btb/a2pico/A2Pico.v2.7/A2Pico.v2.7.sch.pdf

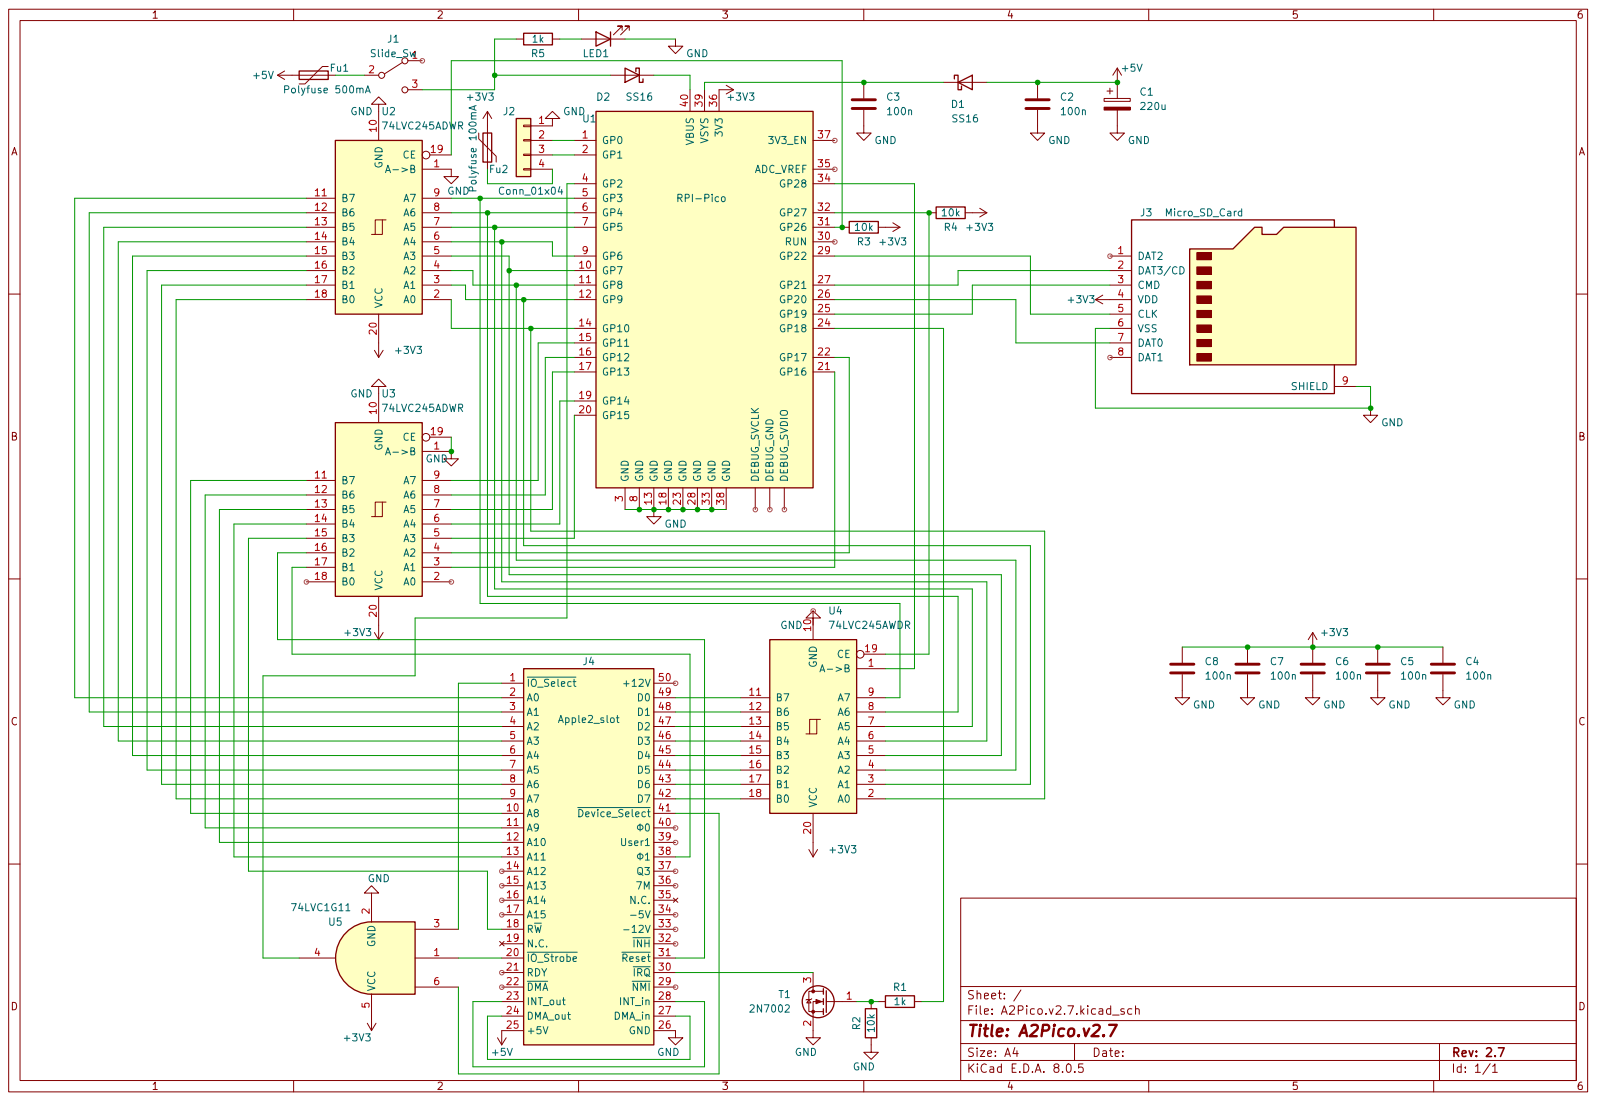
[picture p2: page 1]
