btb/a2pico/A2Pico.v2.6/A2Pico.v2.6.sch.pdf

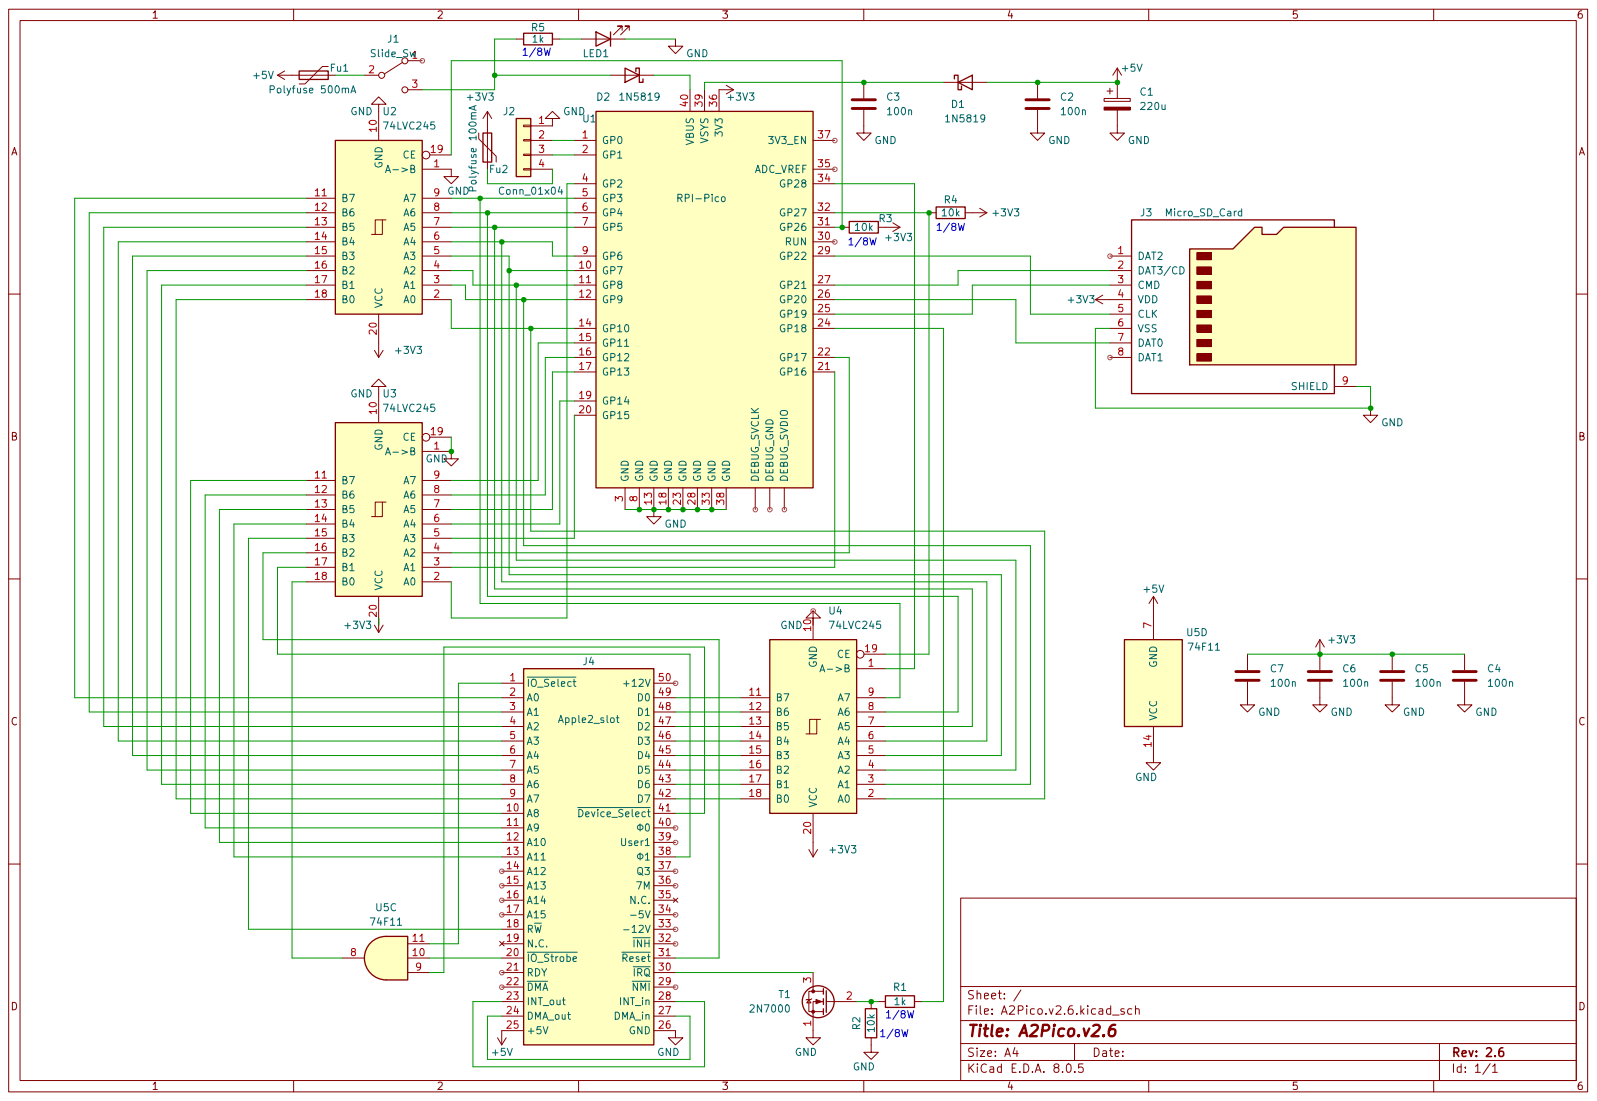
[picture p3: page 1]
