btb/a2pico/A2Pico.v2.7.BookII/A2Pico.v2.7.BookII.kicad_pcb

## KiCad design A2Pico.v2.7.BookII/A2Pico.v2.7.BookII.kicad_pcb (2026-09-29)

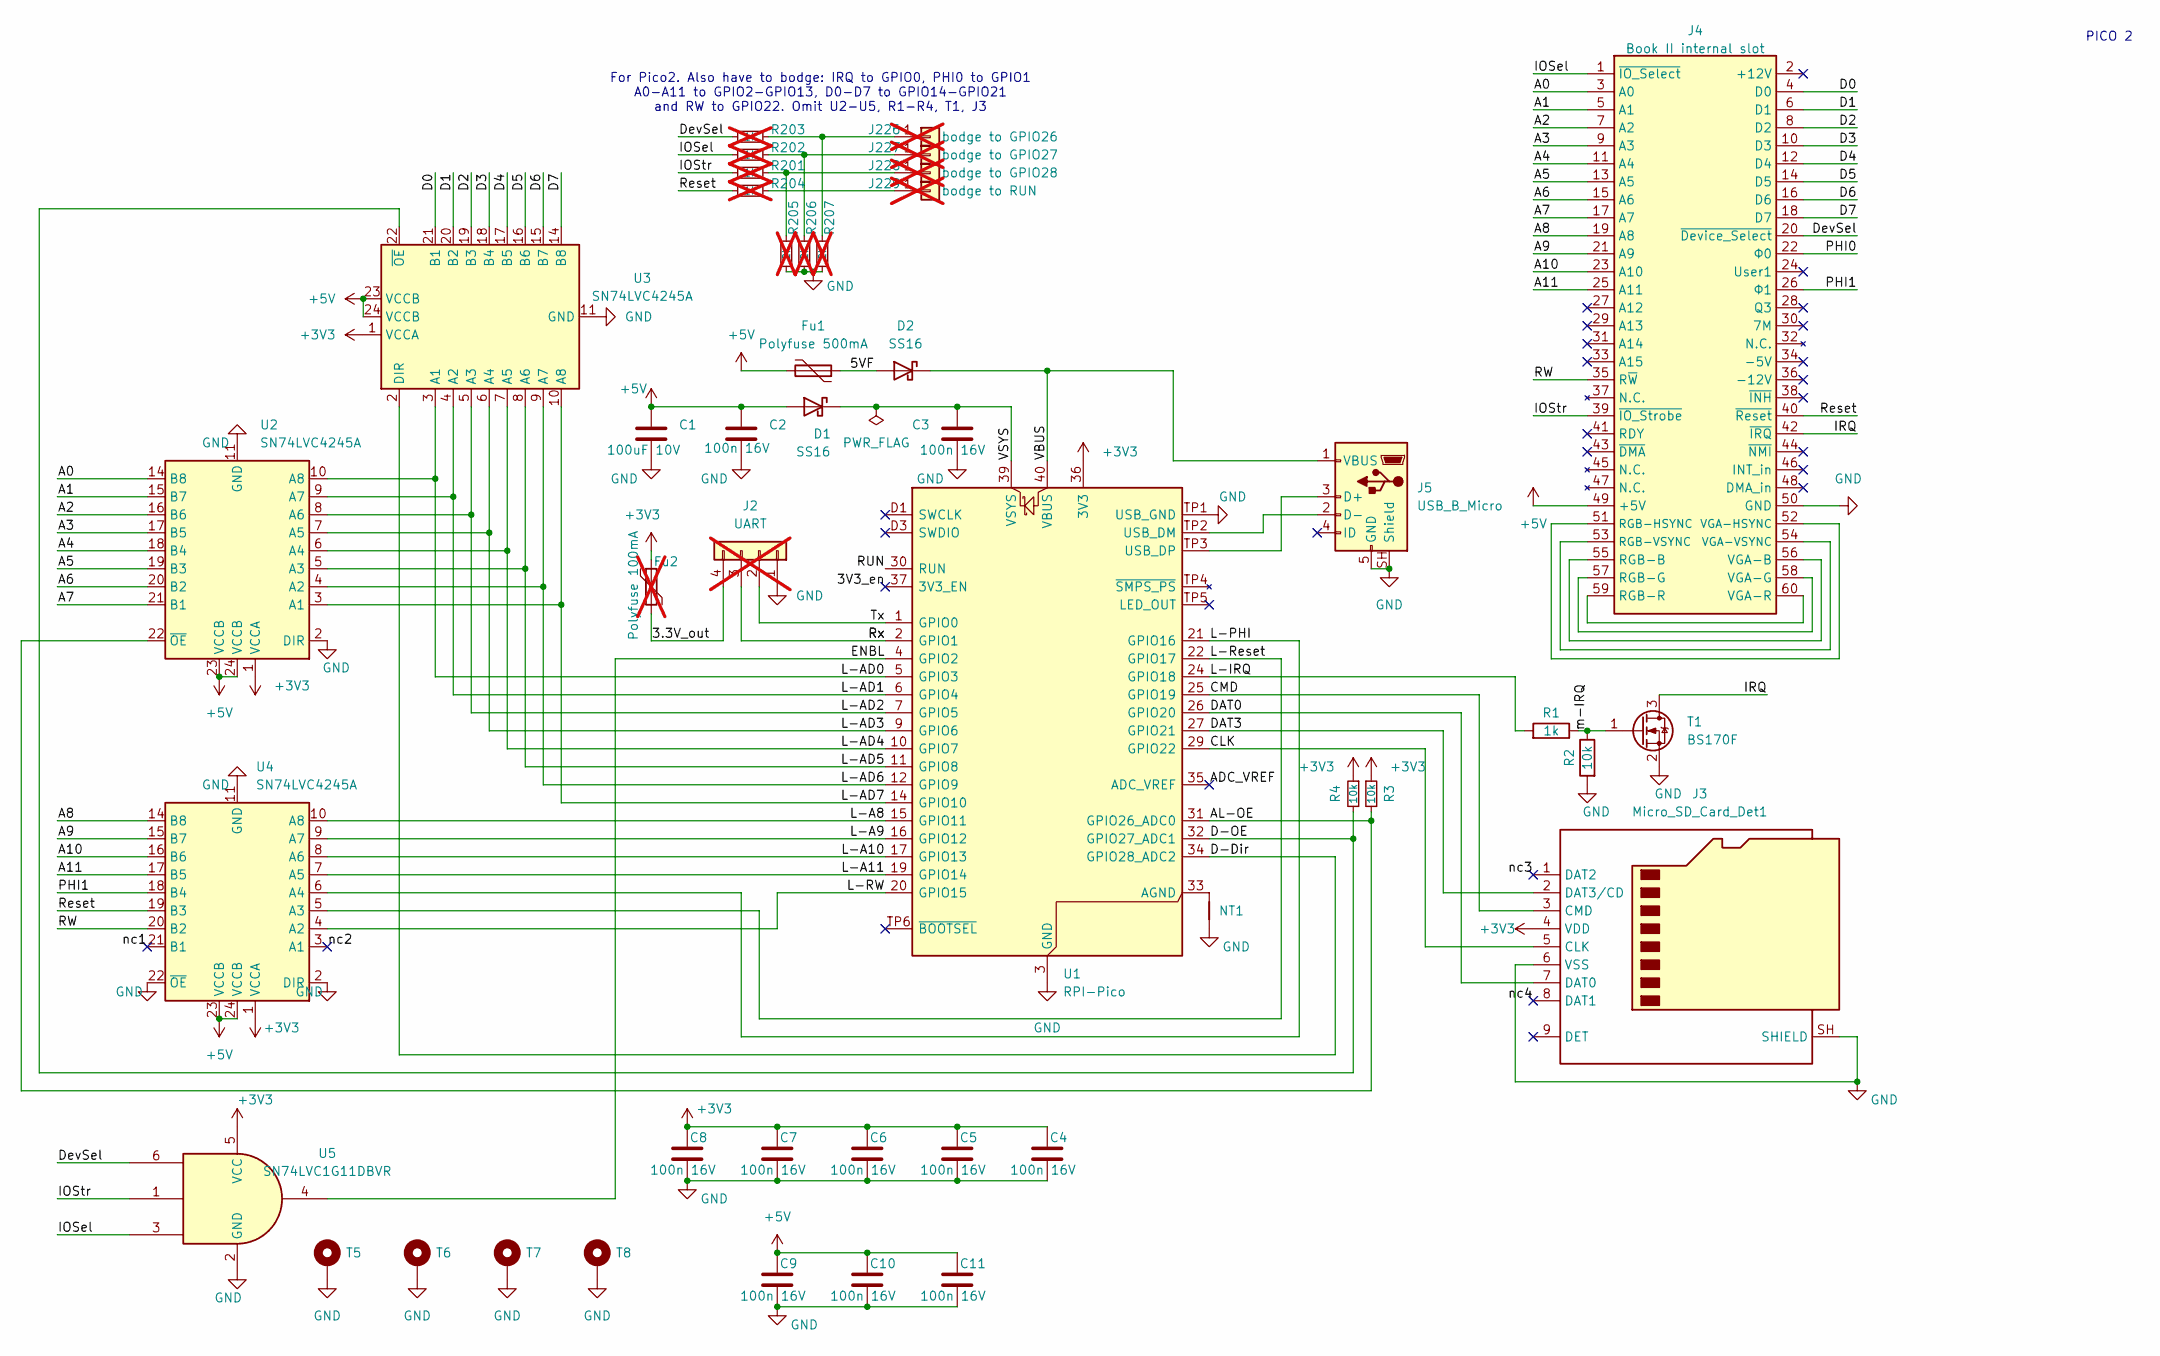
[picture p4: schematic A2Pico.v2.7.BookII.kicad_sch, A2Pico.v2.7 for Book II]

Parts:
C1: 100uF 10V; C_1206_3216Metric_Pad1.33x1.80mm_HandSolder; JLCPCB Part # C15008
C2, C3, C4, C5, C6, C7, C8, C9, C10, C11: 100n 16V; C_0603_1608Metric_Pad1.08x0.95mm_HandSolder; JLCPCB Part # C14663
D1, D2: SS16; D_SMA_Handsoldering; JLCPCB Part # C2480
Fu1: Polyfuse 500mA; Fuse_0805_2012Metric_Pad1.15x1.40mm_HandSolder; JLCPCB Part # C269102
Fu2: Polyfuse 100mA; Fuse_0805_2012Metric_Pad1.15x1.40mm_HandSolder; JLCPCB Part # C269101; not fitted
J2: UART; PinHeader_1x04_P2.54mm_Horizontal; not fitted
J3: Micro_SD_Card_Det1; MicroSD_CUI_MSD-4-A; JLCPCB Part # C52750848
J4: Book II internal slot; PinSocket_2x30_P2.54mm_Vertical
J5: USB_B_Micro; USB_Micro-B_Amphenol_10118193-0001LF_Horizontal; JLCPCB Part # C6798311
J226: bodge to GPIO26; PinHeader_1x01_P1.00mm_Vertical; not fitted
J227: bodge to GPIO27; PinHeader_1x01_P1.00mm_Vertical; not fitted
J228: bodge to GPIO28; PinHeader_1x01_P1.00mm_Vertical; not fitted
J229: bodge to RUN; PinHeader_1x01_P1.00mm_Vertical; not fitted
NT1: (no value)
R1: 1k; R_0603_1608Metric_Pad0.98x0.95mm_HandSolder; JLCPCB Part # C21190
R2, R3, R4: 10k; R_0603_1608Metric_Pad0.98x0.95mm_HandSolder; JLCPCB Part # C25804
R201, R202, R203, R204: 1k; R_0603_1608Metric_Pad0.98x0.95mm_HandSolder; not fitted
R205, R206, R207: 2k; R_0603_1608Metric_Pad0.98x0.95mm_HandSolder; not fitted
T1: BS170F; SOT-23_Handsoldering; JLCPCB Part # C8545
T5, T6, T7, T8: MountingHole_Pad; M2.8D4.5
U1: RPI-Pico
U2, U3, U4: SN74LVC4245A; TSSOP-24_4.4x7.8mm_P0.65mm; JLCPCB Part # C7859
U5: SN74LVC1G11DBVR; SOT-23-6_Handsoldering; JLCPCB Part # C22046

Connections:
+3V3: C4.1, C5.1, C6.1, C7.1, C8.2, Fu2.1, J3.4 (VDD), R3.1, R4.1, U1.36 (3V3), U2.1 (VCCA), U3.1 (VCCA), U4.1 (VCCA), U5.5 (VCC)
+5V: C1.1, C2.1, C9.2, C10.1, C11.1, D1.2 (A), Fu1.2, J4.49 (+5V), U2.23 (VCCB), U2.24 (VCCB), U3.23 (VCCB), U3.24 (VCCB), U4.23 (VCCB), U4.24 (VCCB)
/3.3V_out: Fu2.2, J2.4
/3V3_en: U1.37 (3V3_EN)
/5VF: D2.2 (A), Fu1.1
/A0: J4.3 (A0), U2.14 (B8)
/A1: J4.5 (A1), U2.15 (B7)
/A2: J4.7 (A2), U2.16 (B6)
/A3: J4.9 (A3), U2.17 (B5)
/A4: J4.11 (A4), U2.18 (B4)
/A5: J4.13 (A5), U2.19 (B3)
/A6: J4.15 (A6), U2.20 (B2)
/A7: J4.17 (A7), U2.21 (B1)
/A8: J4.19 (A8), U4.14 (B8)
/A9: J4.21 (A9), U4.15 (B7)
/A10: J4.23 (A10), U4.16 (B6)
/A11: J4.25 (A11), U4.17 (B5)
/ADC_VREF: U1.35 (ADC_VREF)
/AL-OE: R3.2, U1.31 (GPIO26_ADC0), U2.22 (~OE)
/CLK: J3.5 (CLK), U1.29 (GPIO22)
/CMD: J3.3 (CMD), U1.25 (GPIO19)
/D0: J4.4 (D0), U3.21 (B1)
/D1: J4.6 (D1), U3.20 (B2)
/D2: J4.8 (D2), U3.19 (B3)
/D3: J4.10 (D3), U3.18 (B4)
/D4: J4.12 (D4), U3.17 (B5)
/D5: J4.14 (D5), U3.16 (B6)
/D6: J4.16 (D6), U3.15 (B7)
/D7: J4.18 (D7), U3.14 (B8)
/D-Dir: U1.34 (GPIO28_ADC2), U3.2 (DIR)
/D-OE: R4.2, U1.32 (GPIO27_ADC1), U3.22 (~OE)
/DAT0: J3.7 (DAT0), U1.26 (GPIO20)
/DAT3: J3.2 (DAT3/CD), U1.27 (GPIO21)
/DevSel: J4.20 (~Device_Select), R203.1, U5.6
/ENBL: U1.4 (GPIO2), U5.4
/IOSel: J4.1 (~IO_Select), R202.1, U5.3
/IOStr: J4.39 (~IO_Strobe), R201.1, U5.1
/IRQ: J4.42 (~IRQ), T1.3 (D)
/L-A8: U1.15 (GPIO11), U4.10 (A8)
/L-A9: U1.16 (GPIO12), U4.9 (A7)
/L-A10: U1.17 (GPIO13), U4.8 (A6)
/L-A11: U1.19 (GPIO14), U4.7 (A5)
/L-AD0: U1.5 (GPIO3), U2.10 (A8), U3.3 (A1)
/L-AD1: U1.6 (GPIO4), U2.9 (A7), U3.4 (A2)
/L-AD2: U1.7 (GPIO5), U2.8 (A6), U3.5 (A3)
/L-AD3: U1.9 (GPIO6), U2.7 (A5), U3.6 (A4)
/L-AD4: U1.10 (GPIO7), U2.6 (A4), U3.7 (A5)
/L-AD5: U1.11 (GPIO8), U2.5 (A3), U3.8 (A6)
/L-AD6: U1.12 (GPIO9), U2.4 (A2), U3.9 (A7)
/L-AD7: U1.14 (GPIO10), U2.3 (A1), U3.10 (A8)
/L-IRQ: R1.2, U1.24 (GPIO18)
/L-PHI: U1.21 (GPIO16), U4.6 (A4)
/L-RW: U1.20 (GPIO15), U4.4 (A2)
/L-Reset: U1.22 (GPIO17), U4.5 (A3)
/PHI0: J4.22 (Ф0)
/PHI1: J4.26 (Ф1), U4.18 (B4)
/RUN: U1.30 (RUN)
/RW: J4.35 (R~W), U4.20 (B2)
/Reset: J4.40 (~Reset), R204.1, U4.19 (B3)
/Rx: J2.3, U1.2 (GPIO1)
/Tx: J2.2, U1.1 (GPIO0)
/VBUS: D2.1 (K), J5.1 (VBUS), U1.40 (VBUS)
/VSYS: C3.1, D1.1 (K), U1.39 (VSYS)
/m-IRQ: R1.1, R2.1, T1.1 (G)
/nc1: U4.21 (B1)
/nc2: U4.3 (A1)
/nc3: J3.1 (DAT2)
/nc4: J3.8 (DAT1)
GND: C1.2, C2.2, C3.2, C4.2, C5.2, C6.2, C7.2, C8.1, C9.1, C10.2, C11.2, J2.1, J3.6 (VSS), J3.SH (SHIELD), J4.50 (GND), J5.5 (GND), J5.SH (Shield), NT1.2, R2.2, R205.1, R206.1, R207.1, T1.2 (S), T5.1 (1_1), T6.1 (1_1), T7.1 (1_1), T8.1 (1_1), U1.3 (GND), U1.8 (GND), U1.13 (GND), U1.18 (GND), U1.23 (GND), U1.28 (GND), U1.38 (GND), U1.D2 (GND), U1.TP1 (USB_GND), U2.2 (DIR), U2.11 (GND), U2.12 (GND), U2.13 (GND), U3.11 (GND), U3.12 (GND), U3.13 (GND), U4.2 (DIR), U4.11 (GND), U4.12 (GND), U4.13 (GND), U4.22 (~OE), U5.2 (GND)
unnamed: J4.55 (RGB-B), J4.56 (VGA-B)
unnamed: J4.57 (RGB-G), J4.58 (VGA-G)
unnamed: J4.51 (RGB-HSYNC), J4.52 (VGA-HSYNC)
unnamed: J4.59 (RGB-R), J4.60 (VGA-R)
unnamed: J4.53 (RGB-VSYNC), J4.54 (VGA-VSYNC)
unnamed: J5.3 (D+), U1.TP3 (USB_DP)
unnamed: J5.2 (D-), U1.TP2 (USB_DM)
unnamed: J226.1 (Pin_1_1), R203.2, R207.2
unnamed: J227.1 (Pin_1_1), R202.2, R206.2
unnamed: J228.1 (Pin_1_1), R201.2, R205.2
unnamed: J229.1 (Pin_1_1), R204.2
unnamed: NT1.1, U1.33 (AGND)

Notes on the sheet:
PICO 2
For Pico2. Also have to bodge: IRQ to GPIO0, PHI0 to GPIO1 A0-A11 to GPIO2-GPIO13, D0-D7 to GPIO14-GPIO21 and RW to GPIO22. Omit U2-U5, R1-R4, T1, J3

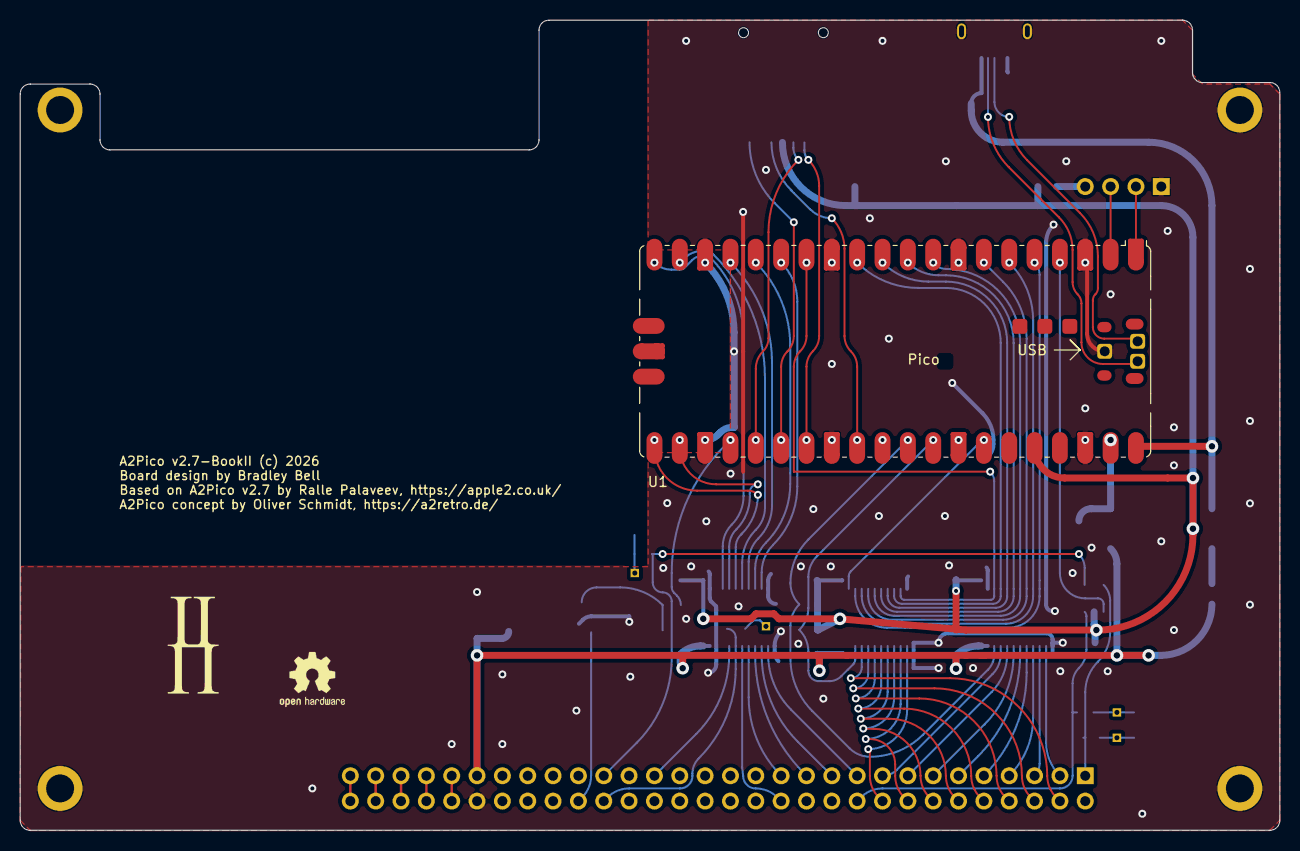
[picture p5: board A2Pico.v2.7.BookII.kicad_pcb from above]

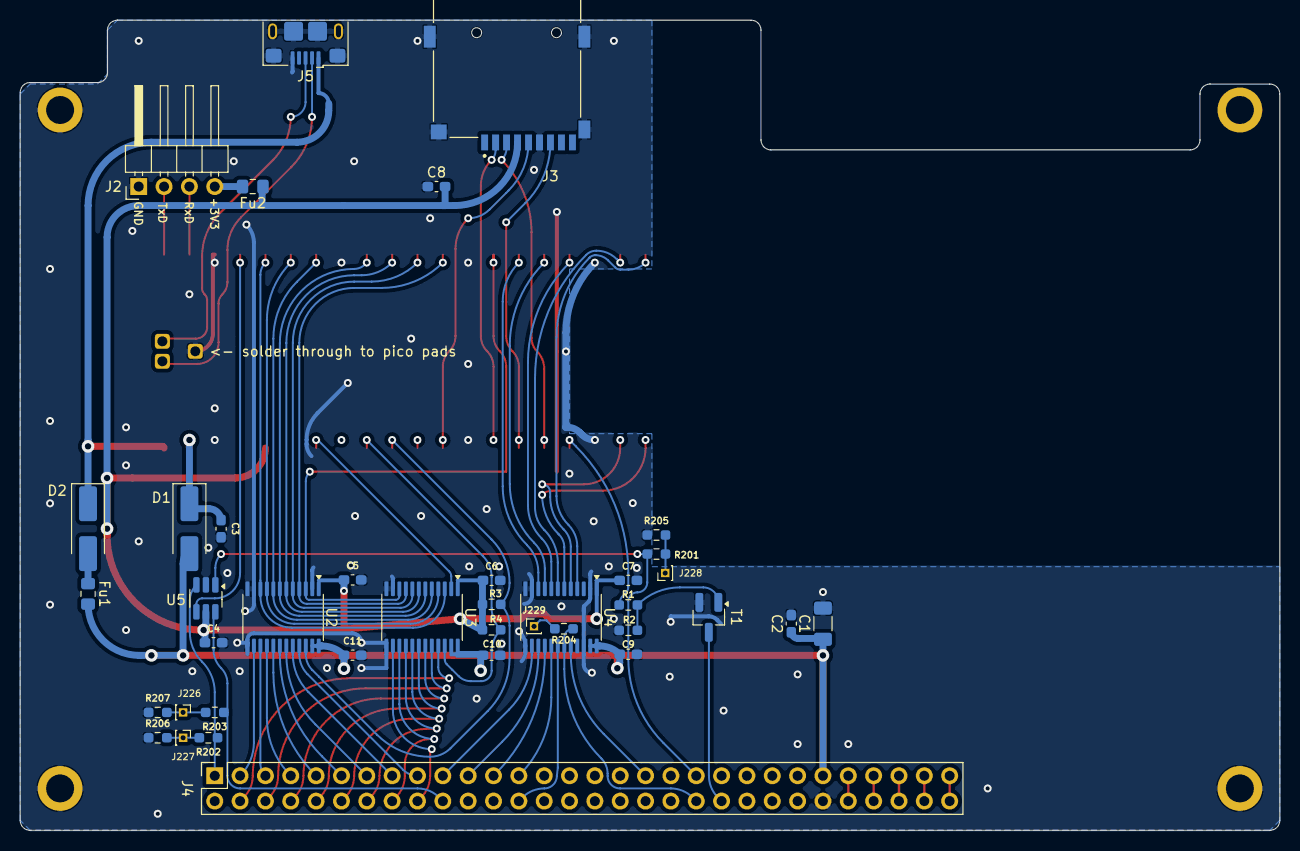
[picture p6: board A2Pico.v2.7.BookII.kicad_pcb from below]

Board: 2 copper layers, 126.2 x 81.2 mm, 44 parts (39 on the bottom side), 72 nets.
