btb/a2pico/A2Pico.v2.6/A2Pico.v2.6.kicad_pcb

## KiCad design A2Pico.v2.6/A2Pico.v2.6.kicad_pcb (2026-02-10, an earlier design)

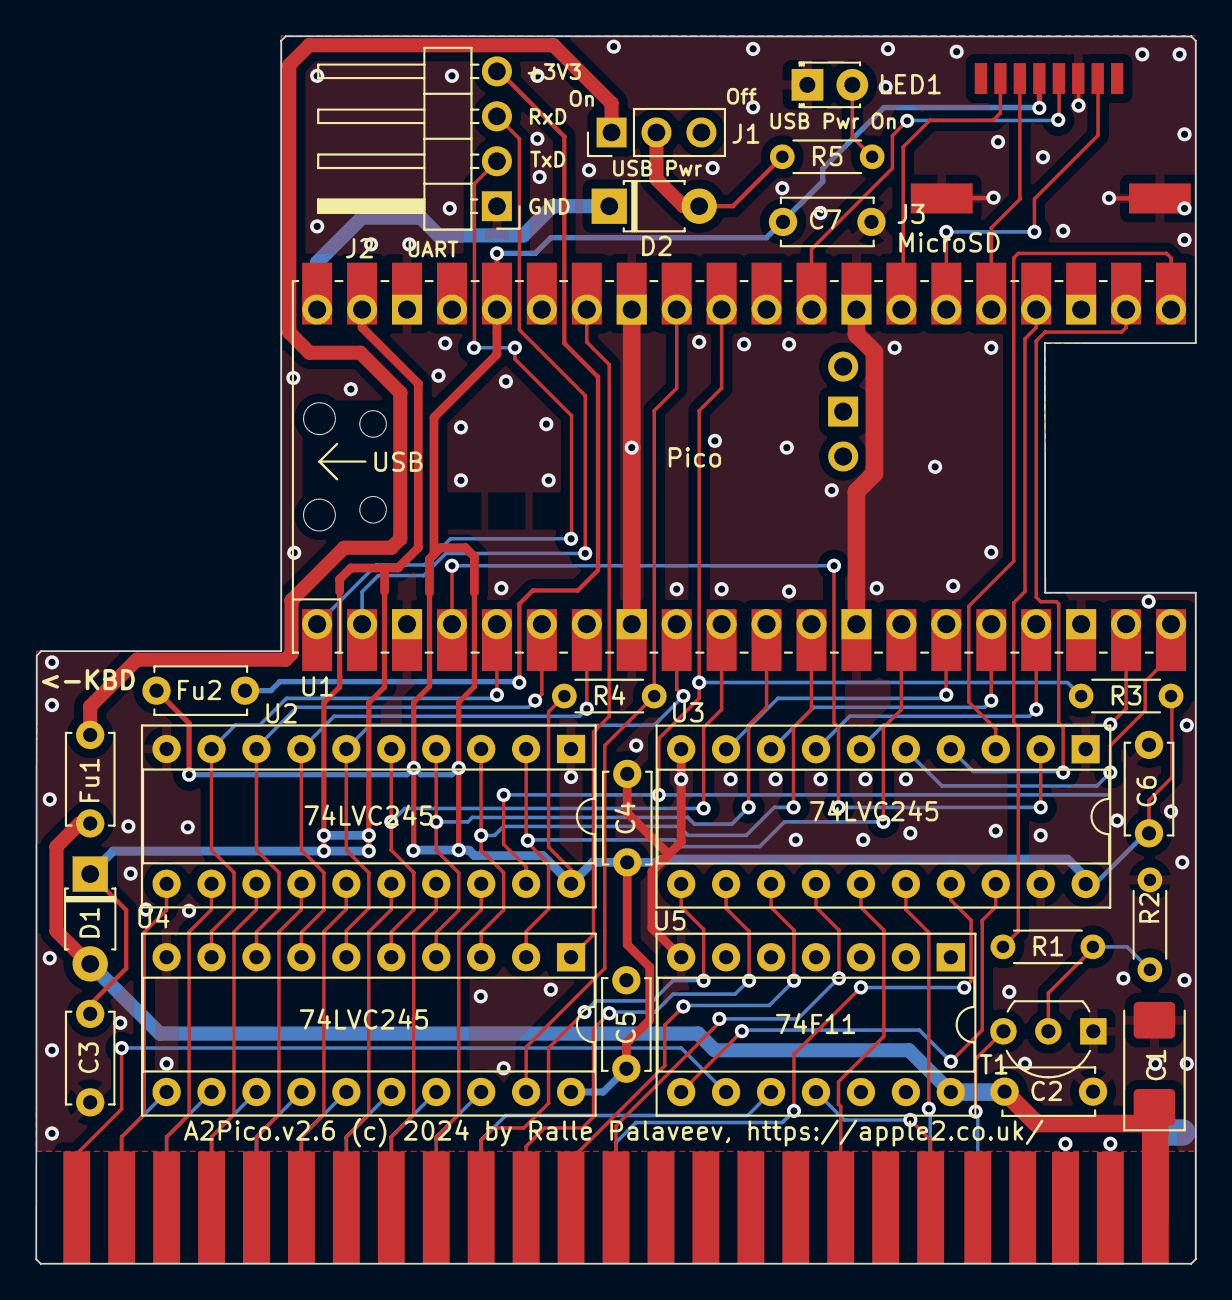
[picture p7: board A2Pico.v2.6.kicad_pcb from above]

Board: 2 copper layers, 65.5 x 69.4 mm, 25 parts (0 on the bottom side), 31 nets.

Parts:
C1: 220uF; CP_EIA-6032-15_Kemet-U
C2, C3, C4, C5, C6, C7: 100n; C_Disc_D5.0mm_W2.5mm_P5.00mm
D1, D2: D_T-1_P5.08mm_Horizontal
Fu1: 500mA; C_Disc_D5.0mm_W2.5mm_P5.00mm
Fu2: 100mA; C_Disc_D5.0mm_W2.5mm_P5.00mm
J1: PinHeader_1x03_P2.54mm_Vertical
J2: PinHeader_1x04_P2.54mm_Horizontal
LED1: LED_D1.8mm_W3.3mm_H2.4mm
R1, R5: 1k; R_Axial_DIN0204_L3.6mm_D1.6mm_P5.08mm_Horizontal
R2, R3, R4: 10k; R_Axial_DIN0204_L3.6mm_D1.6mm_P5.08mm_Horizontal
T1: TO-92L_Inline_Wide
U1: Pico / PicoW; RPi_PicoW_SMD_TH
U2, U3, U4: 74LVC245; DIP-20_W7.62mm_Socket
U5: 74F11; DIP-14_W7.62mm_Socket

Connections:
3.3V: C4.1, C5.1, C6.1, C7.1, Fu2.1, R3.1, R4.2, U1.36 (3V3), U2.20, U3.20, U4.20
3.3V_out: Fu2.2, J2.4
5V: C1.1, C2.2, D1.2, Fu1.1, U5.14
AL-OE: R3.2, U1.31 (GPIO26_ADC0), U2.19
D-Dir: U1.34 (GPIO28_ADC2), U4.1
D-OE: R4.1, U1.32 (GPIO27_ADC1), U4.19
ENBL: U3.18, U5.8
GND: C1.2, C2.1, C3.1, C4.2, C5.2, C6.2, C7.2, J2.1, LED1.1, R2.2, T1.1, U1.3 (GND), U1.8 (GND), U1.13 (GND), U1.18 (GND), U1.23 (GND), U1.28 (GND), U1.33 (AGND), U1.38 (GND), U2.1, U2.10, U3.1, U3.10, U3.19, U4.10, U5.7
J1-1: Fu1.2, J1.1
J1-2: D2.2, J1.2, R5.2
L-A8: U1.15 (GPIO11), U3.9
L-A9: U1.16 (GPIO12), U3.8
L-A10: U1.17 (GPIO13), U3.7
L-A11: U1.19 (GPIO14), U3.6
L-AD0: U1.5 (GPIO3), U2.9, U4.9
L-AD1: U1.6 (GPIO4), U2.8, U4.8
L-AD2: U1.7 (GPIO5), U2.7, U4.7
L-AD3: U1.9 (GPIO6), U2.6, U4.6
L-AD4: U1.10 (GPIO7), U2.5, U4.5
L-AD5: U1.11 (GPIO8), U2.4, U4.4
L-AD6: U1.12 (GPIO9), U2.3, U4.3
L-AD7: U1.14 (GPIO10), U2.2, U4.2
L-ENBL: U1.4 (GPIO2), U3.2
L-IRQ: R1.2, U1.24 (GPIO18)
L-PHI1: U1.21 (GPIO16), U3.3
L-RW: U1.20 (GPIO15), U3.5
L-Reset: U1.22 (GPIO17), U3.4
Rx: J2.3, U1.2 (GPIO1)
Tx: J2.2, U1.1 (GPIO0)
VBUS: D2.1, U1.40 (VBUS)
VSYS: C3.2, D1.1, U1.39 (VSYS)
