btb/a2pico/(commit log)

2026-09-29 Add A2Pico for the Book II
    [A2Pico.v2.7.BookII.kicad_pcb, A2Pico.v2.7.BookII.kicad_sch]
2026-09-29 Add production files
    [bom.csv, designators.csv, positions.csv]
