btb/a2pico/(notices)

Notices in the files:
A2Pico.v2.6/A2Pico.v2.6.kicad_pcb:
A2Pico v2.6 (c) 2024
A2Pico.v2.6 (c) 2024 by Ralle Palaveev, https://apple2.co.uk
A2Pico.v2.7.BookII/A2Pico.v2.7.BookII.kicad_pcb:
A2Pico v2.7-BookII (c) 2026
